thomastech/PixelRadio/include/readme.txt

Apr-14-2022
This folder is for your special include files. It is currently an empty folder.
