thomastech/PixelRadio/docs/Hardware/Schematic_RevB.pdf

# PIXEL RADIO

# FM Transmitter with RBDS/RDS

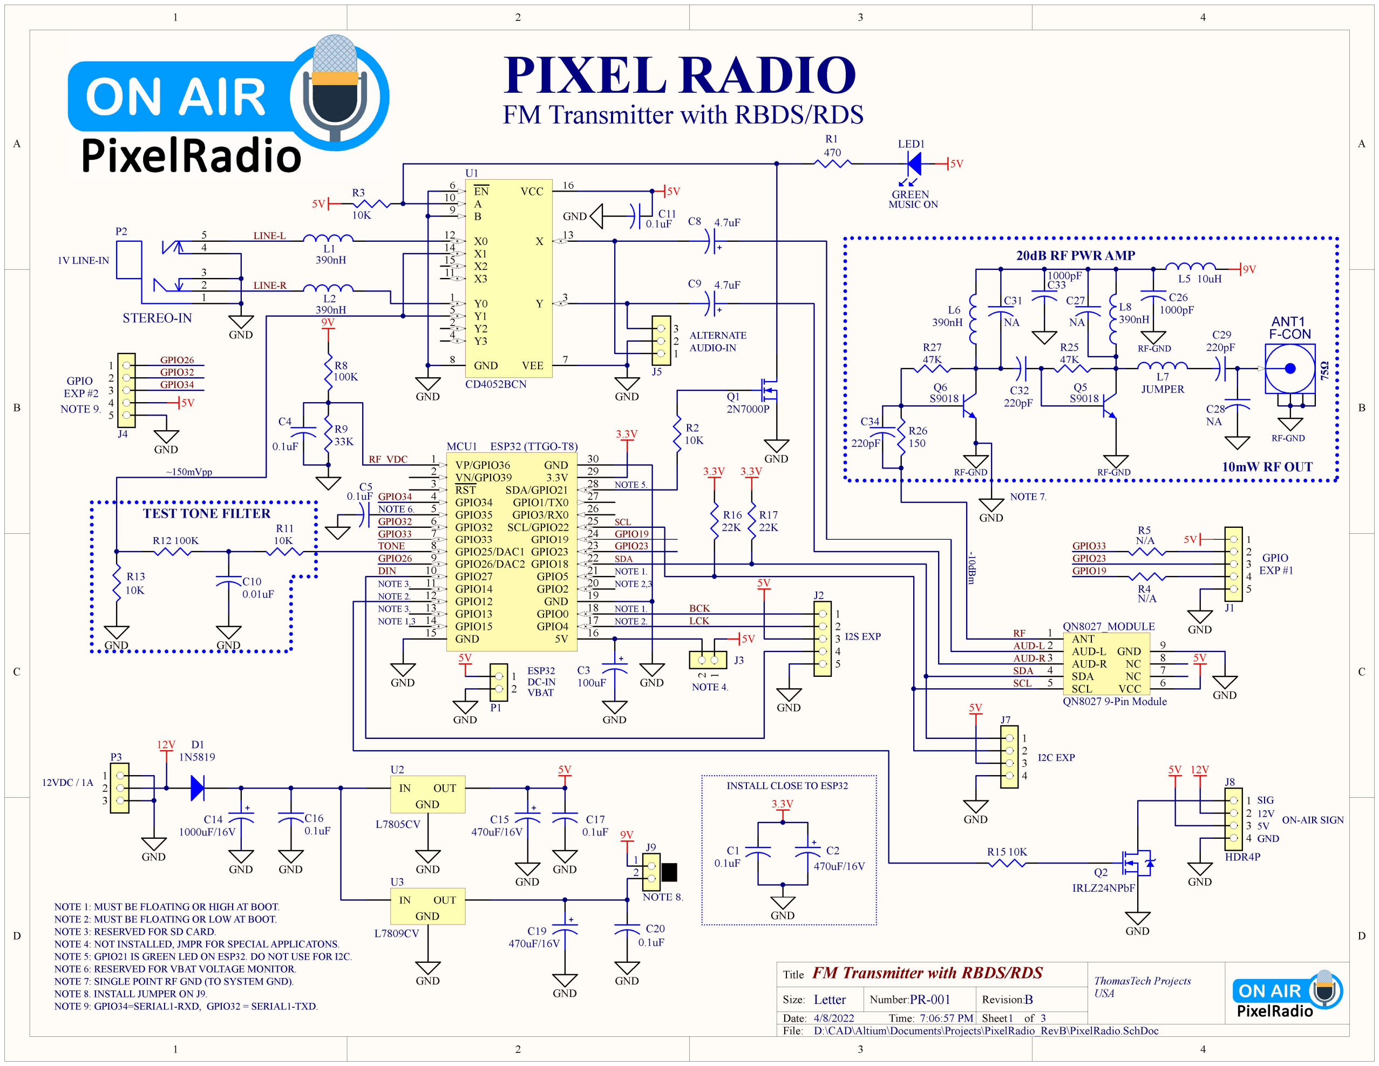
[picture p14: page 1]

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
ThomasTech Projects
USA

## FM Transmitter with RBDS/RDS

PR-001 | B
4/8/2022 | 7:06:57 PM
D:\CAD\Altium\Documents\Projects\PixelRadio_RevB\PixelRadio.SchDoc

Title

Size: | Number:
Date:
File:

Revision:
Time: | Sheet | of

### Letter

3.3V 29
RST 3

VP/GPIO36 1
VN/GPIO39 2

GPIO34 4

GPIO32 6
GPIO33 7
GPIO25/DAC1 8
GPIO26/DAC2 9
GPIO27 10
GPIO14 11
GPIO12 12
GPIO13 13

GND 30

GPIO15 14

GPIO2 | 20
GPIO0 | 18
GPIO4 | 17
GPIO5 | 21 GPIO18 | 22
GPIO19 | 24
SDA/GPIO21 | | 28
GPIO3/RX0 | 26 GPIO1/TX0 | 27
SCL/GPIO22 | | 25
GPIO23 | | 23
GND | 19

GPIO35 5

GND 15 | 5V | 16

MCU1 ESP32 (TTGO-T8)

GND

3.3V

NOTE 1,3

NOTE 1.
NOTE 2,3
NOTE 2.

NOTE 2: MUST BE FLOATING OR LOW AT BOOT.

NOTE 1: MUST BE FLOATING OR HIGH AT BOOT.

NOTE 2.

NOTE 1.

+
C3
100uF

GND

GND

GND

SDA

NOTE 3: RESERVED FOR SD CARD.

NOTE 3.

NOTE 3.

BCK
LCK

GND

3.3V

+
C2
470uF/16V

C1
0.1uF

INSTALL CLOSE TO ESP32

### ANT1 F-CON

5V

NOTE 4: NOT INSTALLED, JMPR FOR SPECIAL APPLICATONS.

### TEST TONE FILTER

R11
R12 100K | 10K

R13
10K
GND | GND

GND

1V LINE-IN

NOTE 5: GPIO21 IS GREEN LED ON ESP32. DO NOT USE FOR I2C.

NOTE 5.

SDA
C10
0.01uF

NOTE 6.

NOTE 6: RESERVED FOR VBAT VOLTAGE MONITOR.

C5
0.1uF

1
2
P1

5V

GND

ESP32
DC-IN

ANT 1
AUD-L 2
AUD-R 3
SDA 4
SCL 5 | VCC | 6
| NC | 7
NC | 8
GND | 9

QN8027_MODULE

QN8027 9-Pin Module

+

C8 4.7uF +

C9 4.7uF
C31

NA

L6
390nH

C26
1000pF

9V

Q6
S9018

R27
47K

SCL

SCL

R8
100K

R9
33K

C4

0.1uF

IN OUT GND

U2

L7805CV

IN OUT GND

U3

L7809CV

D1
1N5819

GND

GND

9V

5V

+
C15
470uF/16V

GND

+
C19
470uF/16V

GND

### 20dB RF PWR AMP

1
2
3

P3

GND

+
C14
1000uF/16V

GND

C16
0.1uF

C20
0.1uF

GND

GND

5V

NOTE 4. ²

1

J3

GND

DIN

12VDC / 1A

NOTE 7.

NOTE 7: SINGLE POINT RF GND (TO SYSTEM GND).

R26
150

R16
22K

R17
22K

3.3V 3.3V

C17
0.1uF

GND

RF
AUD-L
AUD-R

LINE-L

LINE-R

Y2 2

Y0 1 | Y

3

Y3 4

VCC 16

Y1 5

EN 6

X

13

VEE 7 GND 8

X0 12

B

9

A

10

X3 11 | X2 15 | X1 14

U1

CD4052BCN
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
ALTERNATE
AUDIO-IN

Q1
2N7000P

GND

R3

10K

5V

R2
10K
~150mVpp | -10dBm

C11
0.1uF GND

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
I2S EXP

12V

R15 10K

GND

1
2
3
4

J8

HDR4P

GND

12V

ON-AIR SIGN

Q2
IRLZ24NPbF

LED1

GREEN

R1
470
5V

MUSIC ON

L1
390nH

L2
390nH

1
2
3
4

J7

GND

5V

I2C EXP
5V

NOTE 9: GPIO34=SERIAL1-RXD, GPIO32 = SERIAL1-TXD.

SIG
12V
5V

# GND 75Ω

### STEREO-IN

L5 10uH

J9
1
2

NOTE 8.

1
2
3
4
5
J1

GND

5V GPIO19
GPIO23
GPIO33 | R5 N/A

R4
N/A

GPIO33
GPIO23
GPIO19

GPIO

C29
220pF

RF_VDC

VBAT

### 10mW RF OUT

C34

220pF

L8
390nH

Q5
S9018

R25
47K

C32
220pF

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
GPIO32

GPIO26

GPIO34

GPIO26
GPIO32
GPIO34

TONE

GPIO
EXP #2

EXP #1

RF-GND | RF-GND

RF-GND

RF-GND

NOTE 8. INSTALL JUMPER ON J9.

NOTE 9.

L7
JUMPER
C28
NA

C33

1000pF

# PROJECT REFERENCE INFORMATION

# PIXEL RADIO

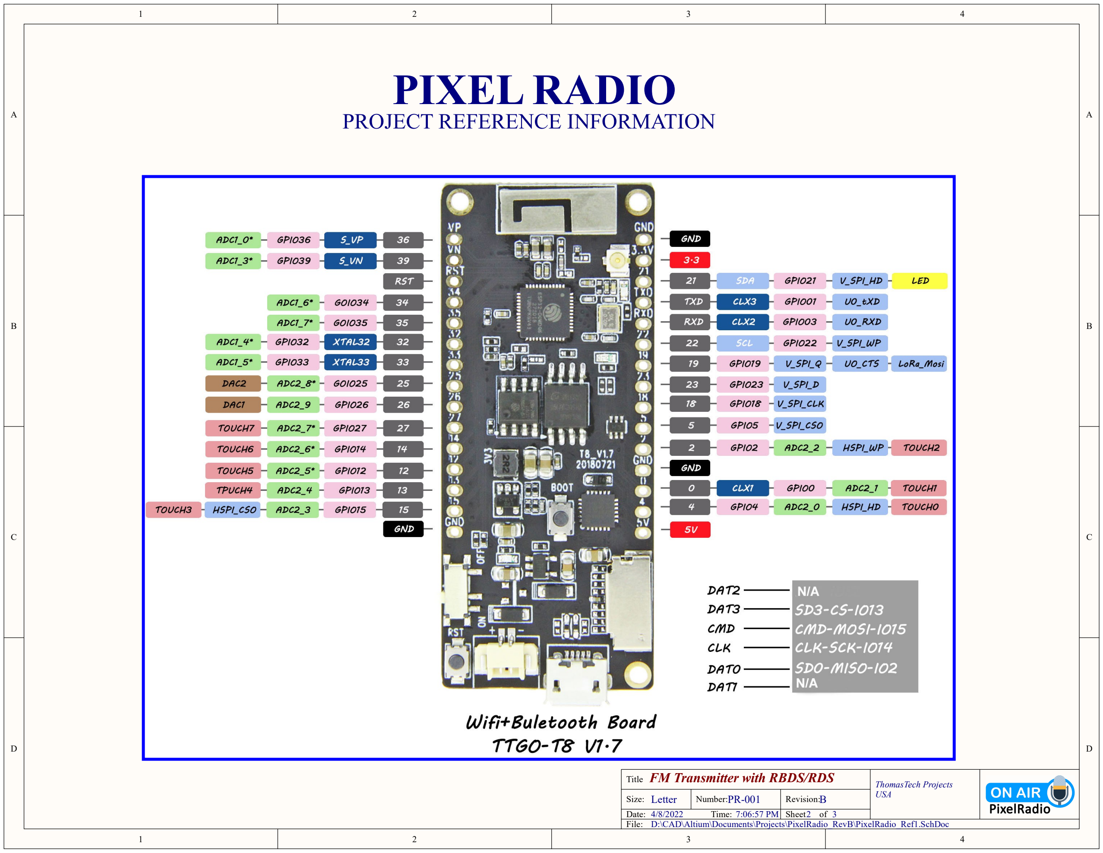
[picture p15: page 2]

D D

C C

B B

A A

## FM Transmitter with RBDS/RDS

D:\CAD\Altium\Documents\Projects\PixelRadio_RevB\PixelRadio_Ref1.SchDoc

Title

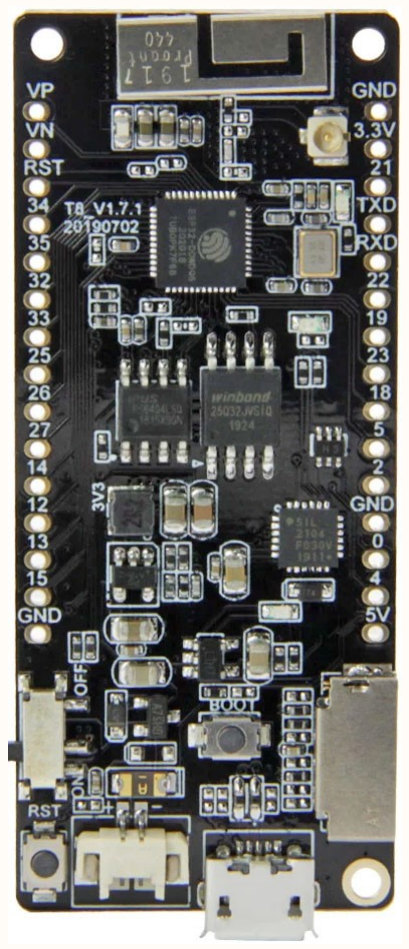
[picture p16: figure]
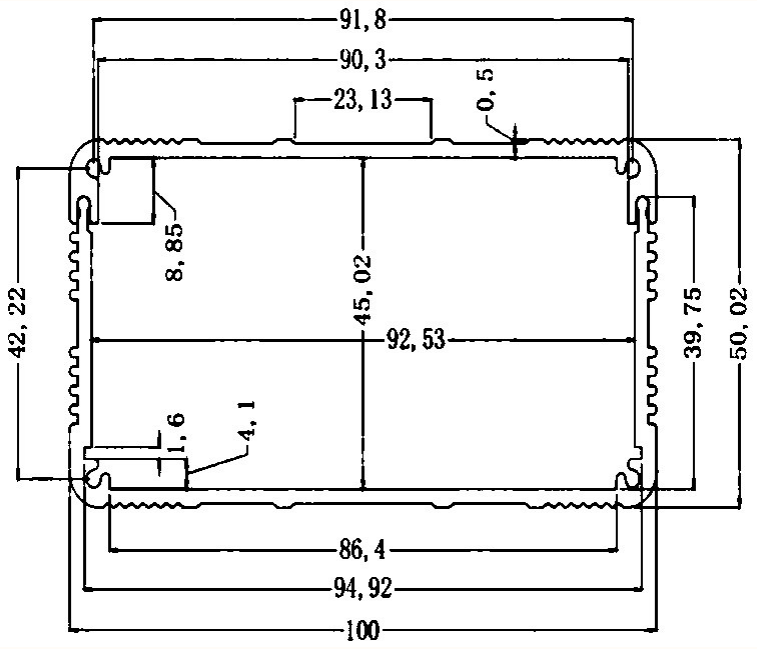
[picture p17: figure]
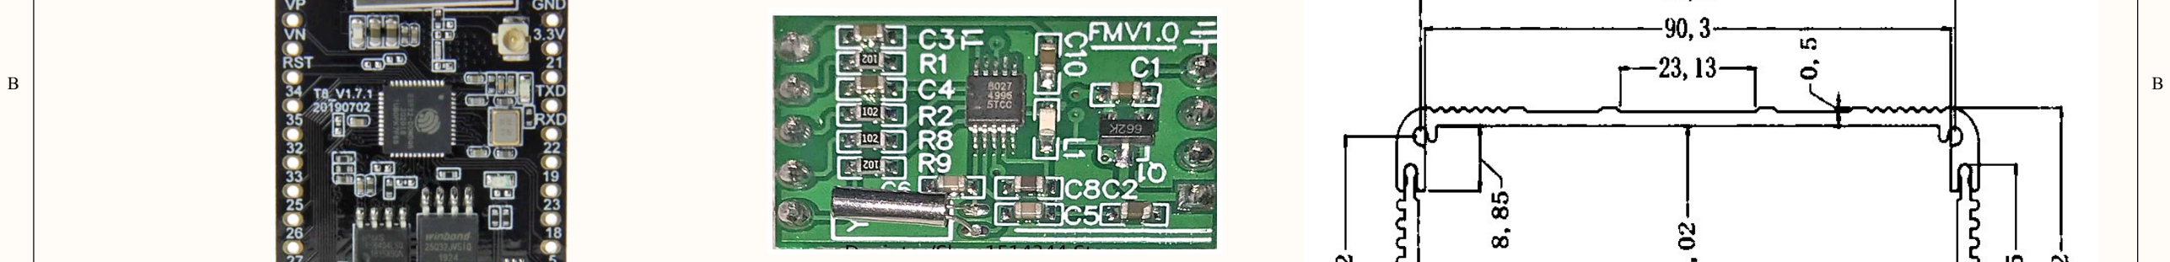
[picture p18: figure]

D D

C C

A A

## FM Transmitter with RBDS/RDS

D:\CAD\Altium\Documents\Projects\PixelRadio_RevB\PixelRadio_Ref2.SchDoc

Title

# PROJECT REFERENCE INFORMATION

# PIXEL RADIO

## ESP32 TTGO-T8 V1.7.1

## QN8027 FM TRANSMITTER

## METAL ENCLOSURE, FRONT VIEW
