thomastech/PixelRadio/docs/Images/README.md

# 

# IMAGES

PixelRadio is a DiY FM Radio Transmitter with RDS (Radio Data System) capabilities. It was developed for holiday "Pixel" displays (e.g., animated Christmas lights).

This folder contains the images used in the project's documentation.
