thomastech/PixelRadio/docs/Images/radioFail1_400.png

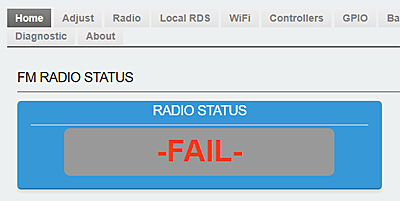
docs/Images/radioFail1_400.png
