thomastech/PixelRadio/docs/User_Manual/AboutTab.md

# 

# ABOUT TAB

PixelRadio is a FM Radio Transmitter with RDS (Radio Data System) capabilities. It was developed for holiday "Pixel" displays (e.g., animated Christmas lights).

The About Tab reports the software version and build date.

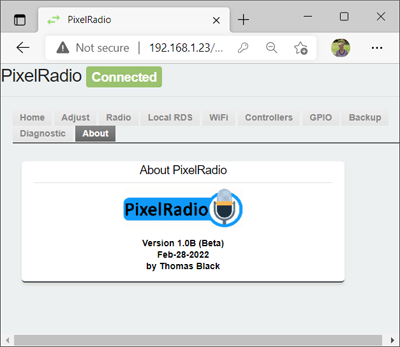
[picture p42: docs/Images/aboutTab1_400.png]


&nbsp;&nbsp;&nbsp;

## RETURN TO OVERVIEW

Return to the Menu Overview page: [Click Here](./Overview.md).
