thomastech/PixelRadio/(threads)

Thread 2 (2022-06-02):

System Run Time Freezes after 49 days

thomastech, 2022-06-02:
**Problem:** System Run Time Freezes after 49 days. Max elapsed time is 49 days, 17 hrs, 2 mins, 46 secs.
This is due to the timer's rollover limit. Classic coding mistake, shame on me.

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

This is a non-critical bug. No hurry, add to a future maintenance release.

thomastech, 2022-06-17:
Fixed. Released, see version 1.1.0.

Closed 2022-06-17.

Thread 7 (2022-12-01):

Please include pick and place file

sslupsky, 2022-12-01:
Could you please include the pick and place file for the board?  It would be possible to order an assembled board from JLCPCB if that is available.

thomastech, 2022-12-01:
Attached is the CSV File. Created today, NOT validated, use at your own risk.

[Pick Place for PixelRadio.csv](https://github.com/thomastech/PixelRadio/files/10136341/Pick.Place.for.PixelRadio.csv)

Issue complete, closed ticket.

- Thomas

sslupsky, 2022-12-01:
Thank you.

sslupsky, 2022-12-01:
Apologies, one other thing I noticed, the parts list does not have the footprint.  Could you also please provide a BOM with the footprint?

thomastech, 2022-12-01:
I'm unable to generate a useful footprint list for you without a lot of work on my end. So you'll have to create this on your own.

To get you started, attached is a basic BOM file you can use as a worksheet.

[PCB_Project_BOM.xls](https://github.com/thomastech/PixelRadio/files/10136786/PCB_Project_BOM.xls)

If JLCPCB has success with assembling your PixelRadio board then please come back and share all your files and any tips that might help the next project builder.

- Thomas

sslupsky, 2022-12-01:
Thanks for the BOM.  I can pull most of what I need out of that.  One thing that would help is the lead spacing for the radial caps.

thomastech, 2022-12-02:
The lead spacing measurements for many of the caps can be found in the big discussion at the doityourselfchristmas forum:
http://doityourselfchristmas.com/forums/showthread.php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

- Thomas

sslupsky, 2022-12-02:
Now that you mention it I seem to recall that discussion in the forum thread.  I'll go review again.  I opened the gerbers in my viewer and had a closer look at the lead spacing of those components.

sslupsky, 2022-12-03:
JLCPCB assembly looks like it will be about $50 for 5 boards.  Could save at least $2 per board I think if it was SMT.  This doesn't include the ESP32 or the RF module.

There are a few components that are difficult to source through JLCPCB/LCSC.  The thru hole inductors, the 1000pF and 220pF thru hole caps.

What is the voltage rating on C3?  I cannot find a capacitor with that footprint in a 16V rating.

Here is a screenshot of the JLC cost:
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

Let me know what you think.

sslupsky, 2022-12-03:
One thing that would be helpful is if you could add two 15 pin female headers (for the MCU) to the PCB and regenerate the placement and BOM with these two additional components.

sslupsky, 2022-12-03:
If we used SMT components I think component cost would come down as well.

thomastech, 2022-12-03:
> JLCPCB assembly looks like it will be about $50 for 5 boards.

That is a good deal.

> What is the voltage rating on C3? I cannot find a capacitor with that footprint in a 16V rating.

Minimum C3 voltage is 6.3V.

> Let me know what you think.

Some observations:

* Orientation of D1 is backwards in your screenshot.
* Double check C8 & C9 polarity. Hard to tell in the image but they look backwards to me.
* If you are using the recommended enclosure then LED1 should be hand-stuffed during final assembly so that it aligns with the hole in the front panel.

> One thing that would be helpful is if you could add two 15 pin female headers (for the MCU) to the PCB and regenerate the placement and BOM with these two additional components.

Sorry, you'll have to hand solder those.

> If we used SMT components I think component cost would come down as well.

Yes, for "production builds" an SMT layout would be important. But PixelRadio was released as a hobby project for home builders and through-hole was chosen to reduce the required soldering skills. In regards to home building, the FCC has a allowance for that activity. See Home-Built section:
https://transition.fcc.gov/Bureaus/Engineering_Technology/Documents/bulletins/oet63/oet63rev.pdf

- Thomas

sslupsky, 2022-12-03:
> Minimum C3 voltage is 6.3V.

Is there an ESR requirement for C2 ad C3?

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

Yeah, I have to figure out how to "inform" JLCPCB about forming the leads for U2 and LED1 so they are placed properly.  I am not aware of how to do that.

> > One thing that would be helpful is if you could add two 15 pin female headers (for the MCU) to the PCB and regenerate the placement and BOM with these two additional components.
>
> Sorry, you'll have to hand solder those.

I am not sure I was clear.  I am asking for the headers to be included in the BOM and placement files so the headers can be installed at JLCPCB.

> Yes, for "production builds" an SMT layout would be important. But PixelRadio was released as a hobby project for home builders and through-hole was chosen to reduce the required soldering skills. In regards to home building, the FCC has a allowance for that activity. See Home-Built section: https://transition.fcc.gov/Bureaus/Engineering_Technology/Documents/bulletins/oet63/oet63rev.pdf

I think I understand what you counsel here.  The hobbyist is required to assemble this transmitter by:

1. procurement of the carrier board, enclosure and modules,
2. insertion of the TTGO-T8 module,
3. hand soldering the RF module,
4. programming TTGO-T8 firmware,
5. assembly of enclosure,
6. jumper configuration,
7. attach antenna

The bulletin requires "their designers and builders are required to employ good engineering practices".  I think using JLCPCB assembly service helps to satisfy the "builders" part of this requirement, even more so than someone soldering one entirely from scratch.  You appear to have some significant experience in RF electronics.  So I believe this project meets the "designers" requirement as well.  So, I think the project meets the "home built" test.

thomastech, 2022-12-03:
> Is there an ESR requirement for C2 ad C3?

ESR is not critical. But I suggest using low ESR that's recommended for power supply applications.

> I am asking for the headers to be included in the BOM and placement files so the headers can be installed at JLCPCB.

See attached file (added components HDR1-MCU1 and HDR2-MCU1):
[Pick Place for PixelRadio.csv](https://github.com/thomastech/PixelRadio/files/10147168/Pick.Place.for.PixelRadio.csv)

> I think I understand what you counsel here. My interpretation is the hobbyist is required to assemble this transmitter {snip}

I don't hold a law degree so I can't offer any useful regulatory advice. But my personal method is to be as conservative as practical and do all I can to avoid stepping on gov agency toes.

- Thomas

sslupsky, 2022-12-03:
Are these inductors suitable?
https://www.bourns.com/docs/Product-Datasheets/78f_series.pdf

sslupsky, 2022-12-03:
P2 and P3 coordinates appear to be a bit off.  Can you advise regarding the origin of these components?

U2 coordinates do not match the pcb either.

I fixed polarities on D1, C8 and C9.

Substituted a 25V cap for C3 to fit the footprint.  Perhaps a high capacitance cap would be a better sub?  Not sure what the spec for this pin on TTGO T8 is.

You have a connector installed for J8 shown in the assembly tips.  What connector did you use?

sslupsky, 2022-12-03:
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

sslupsky, 2022-12-03:
I am having a hard time with the inductors (390nH, 10nH) and a few of the caps (1000pF and 220pF).  JLCPCB/LCSC has no stock on these.

thomastech, 2022-12-04:
`Are these inductors suitable?
https://www.bourns.com/docs/Product-Datasheets/78f_series.pdf`
Those are OK.

> P2 and P3 coordinates appear to be a bit off. Can you advise regarding the origin of these components?
Hmm, must be an error in the library. The best I can advise is the location of Pin 1.
P2-1 is center pin far left side, 4.659, 34.116 mm
P3-1 is center pin far left side, 5.334, 14.224 mm

sslupsky, 2022-12-05:
Updated pos of P2, P3 and U2.  Added JST XA header for J8.  Sub 470uF for C3 (used same value as the other caps to minimize number of diff parts).

Waiting for JLCPCB feedback regarding the lead forming.

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

sslupsky, 2022-12-06:
Problem with the lead forming ... JLCPCB does not support that.  I'll see if they will ship the parts with the board so we can solder them.  I do not think they will though.

Good idea on the jumper.  I was looking all over for a wire jumper and did not think of a zero ohm axial resistor.

sslupsky, 2022-12-06:
I am pretty sure the answer to this question is no but can I sub a 10uH inductor for the 390nH inductors?  I found a 10uH thru hole inductor at JLCPCB.

thomastech, 2022-12-07:
> can I sub a 10uH inductor for the 390nH inductors? I found a 10uH thru hole inductor at JLCPCB.
Please use the original value (390nH).

- Thomas

sslupsky, 2022-12-07:
I found a closer match to the 390nH inductor.  It is 150nH.  That seems more suitable but may require an adjustment to the 1000pF capacitor used in the amplifier stage.

The 10uH inductor may still be suitable for the audio input filtering.

thomastech, 2022-12-07:
>  If we use the 150nH inductor and increase the 1000pF cap to 2700pF, would that be suitable?

Regarding the 390nH sub, 150nH is not recommended (will affect performance). And keep in mind that any changes to the RF PA will require a new RF validation to ensure conformity and performance.

> The 10uH inductor may still be suitable for the audio input filtering.

L1 and L2 are for RFI/EMI protection. Changing them to 10uH should be OK, but to prevent surprises be sure to measure audio bandwidth.

- Thomas

kingofkristmas, 2022-12-25:
> I found a closer match to the 390nH inductor in stock. It is 150nH. That seems more suitable but may require an adjustment to the 1000pF capacitor used in the amplifier stage. If we use the 150nH inductor and increase the 1000pF cap to 2700pF, would that be suitable?
>
> The 10uH inductor may still be suitable for the audio input filtering.

Any luck with JLCPCB? They seem to be short on a lot of components.

thomastech, 2023-05-07:
Closed due to lack of activity.

Closed 2023-05-07.

Thread 8 (2022-12-16):

FPP and Pixel Radio Plugin Log Errors

bobreese, 2022-12-16:
I have been finding a lot of errors in my fppd logs.
[General] /opt/fpp/src/common.cpp:1007: curl_easy_perform() failed: Timeout was reached

I ended up turning on the Excessive logs in my PI 4 and found that FPP is trying to get information from the Pixel Radio on its IP:8080.

2022-12-16 10:13:13.392 (9851) [ChannelOut] /opt/fpp/src/channeloutput/UDPOutput.cpp:618: Pinging controllers to see what is online
2022-12-16 10:13:24.547 (9868) [General] /opt/fpp/src/common.cpp:1003: Calling GET http://192.168.0.102:8080/cmd?psn=n Walnut
2022-12-16 10:13:26.549 (9868) [General] /opt/fpp/src/common.cpp:1007: curl_easy_perform() failed: Timeout was reached
2022-12-16 10:13:26.549 (9868) [Plugin] src/FPPPixelRadio.cpp:157: http://192.168.0.102:8080/cmd?psn=n Walnut:   2022-12-16 10:13:26.549 (9868) [General] /opt/fpp/src/common.cpp:1003: Calling GET http://192.168.0.102:8080/cmd?rtm=%7f
2022-12-16 10:13:28.393 (9851) [ChannelOut] /opt/fpp/src/channeloutput/UDPOutput.cpp:618: Pinging controllers to see what is online
2022-12-16 10:13:28.551 (9868) [General] /opt/fpp/src/common.cpp:1007: curl_easy_perform() failed: Timeout was reached

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
[Errors.txt](https://github.com/thomastech/PixelRadio/files/10247645/Errors.txt)

thomastech, 2022-12-16:
Sorry to hear about the issue. Could be poor WiFi to the PixelRadio device (or RPI if it is running wirelessly). Check the RSSI and confirm good signal strength throughout the show.

But beyond that you'll need to report this issue to the FPP-PixelRadio plugin developer. Dan's repo is here:
https://github.com/FalconChristmas/fpp-PixelRadio

- Thomas

bobreese, 2022-12-16:
-38 to 42dBm with the show running.
I did post over in Dan's repo

thomastech, 2022-12-17:
Thanks for reporting the issue at FalconChristmas. I don't use their PixelRadio plugin so hopefully the dev can duplicate the issue and provide assistance.

- Thomas

Closed 2023-05-07.

Thread 11 (2023-01-26):

Picture of assembled board

muhuna, 2023-01-26:
Can you add some picture of the assembled board on the front page. It would help a lot for people to verify they are doing the right thing.

thomastech, 2023-01-26:
Photos and basic hardware build details are published in the documentation.
See:
https://github.com/thomastech/PixelRadio/tree/main/docs/Hardware

Closed 2023-05-07.

Thread 12 (2024-03-13):

Bad VDC

davidcharlessmith516, 2024-03-13:
I continue to receive a 'BAD-VDC' message in the Radio Status box, although the device appears to broadcast properly.

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

I have tried three different 12V power adapters, 500mA, 1A & 2A and they all show roughly the same numbers in the diagnostics.

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

Is there some physical issue with the board that I can troubleshoot? Do I have an incorrect setting somewhere (it's been like this since I first powered it on).

thomastech, 2024-03-14:
The displayed RF PA Voltage measurement is wrong. Should be 9VDC. That is the reason for the BAD-VDC message.

Confirm that jumper J9 is installed. Re-solder the connections to this.
Confirm that you have approx 9VDC across C20.
Confirm that you have approx 9VDC across C26.

If all those things are correct then there is likely a bad solder connection or incorrect component at R8, R9 & C4. And check pin 1 of the MCU1 and its socket.

- Thomas

davidcharlessmith516, 2024-03-14:
Thank you for responding so quickly. I swapped out the jumper for a different one and have the same BAD-VDC. I will search for my multimeter tomorrow to check the voltages, as the rest of the house is asleep right now. In the meantime, I will also share what may be another cause of the issue:

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

In trimming my solder joints, I scraped the board a little bit. Sure enough, this is right in between R8 and R9 where you guessed there could be an issue. In the photo, R8 is on the right and R9 is on the left. Not sure if this is causing the issue and/or if it is repairable if that's the case, but since it is right in the neighborhood of the components you said could have an issue, I thought I'd mention it.

I'll let you know what I come up with on the voltages when I find my multimeter.

Thanks again!

davidcharlessmith516, 2024-03-14:
I had roughly 8.95V across both C20 and C26.
I confirmed continuity across J9 with the jumper installed.
I still had the BAD-VDC message and the same low RF PA Voltage

I went through and resoldered C20, C26, R8, R9 and C4.
This resolved the issue. I now have no error message and 8.8 RF PA Voltage

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

Thank you for your guidance. This is a very neat and extremely useful project that you came up with and I appreciate that you continue to maintain and support it.

thomastech, 2024-03-14:
You are welcome. Thank you for reporting the solution.
- Thomas

Closed 2024-03-14.

Thread 13 (2024-12-02):

URL Decode needed?

kylegrymonprez, 2024-12-02:
The FPP Plugin was failing in curl with malformed URLs. to make it suceed, the Content of the URLs needed to be url encoded so " " would travel across to the pixelradio device as "%20". This seems to work fine for Sont text, however, the station text is displaying at "%20" instead of being URL decoded. I coudlnt' figure out the correct plave to URL decode the strings correctly, so perhaps you could quickly update the correct line of code to properly URL Decode the strings and transmit them correctly.

thomastech, 2024-12-03:
I don't use the FPP plugin that was created by Daniel Kulp. So I might not be able to solve this issue. Here's some ideas:

1. Try replacing the space (or %20) with a plus (+) sign . That is an alternate for a URL space char.
2. Perhaps an underscore ( _ ) instead of %20 will solve this for you. The underscore is fairly stealth looking.

BTW, it is not clear which RDS payload that is causing the grief. When you say "station text," is it the PSN (program station name) that is not working when you pad with %20. Or do you mean a different RDS payload?

Keep in mind that PSN is typically the station call letters, but can be a very short name. Maximum 8 chars, including any encoding characters.

kylegrymonprez, 2024-12-03:
Yeah - I think the plugin is handling cycling the PSN payload - so to get the cURL to succeed to PixelRadio, the URL has to be url encoded.

The Plugin splits it into 8 characters that cycle on a timer. e.g. my show name is "Lights at Ardmore". I set that to the Station ID in the plugin where applicable.
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

The plugin splits that into chunks of 8 characters - I see another issue in my attempted fix that worked for the RDS text, but I'll double check the code again to see if there's a separate issue. Last time I checked it was taking the URL encoded payload for PSN and displaying it verbatim on the display. So "Lights At Ardmore" got split into 3 chunks of 8 characters including the url encoded chars. However I may have spotted an issue in my own code to fix that - just need an radio to verify the other side (because the PixelRadio webpage only displays the RDS love, not the station code..... and I dont have serial logging connected....)

thomastech, 2024-12-04:
It's probably best to check the plugin's code.  It must handle any URL encoding before passing the text string to PixelRadio.

I don't have any experience with the FPP plugin. But thinking about what it should do, one issue is that only 8 chars can be sent to PixelRadio's PSN command at a time. So if %20 encoding is used, and it does not fit in a single 8 char payload, it won't be decoded as a space.
What I mean is, splitting **Lights%20At%20Ardmore** would be broken into:
Payload 1: Lights%2
Payload 2: 0At%20Ar
Payload 3: more

Sending that won't work correctly. So as a workaround, it might be best to use a single character to represent a space. Such hyphens, underscores, tildes, periods, etc.

Keep in mind that using the Station ID for messaging is not actually permitted in the RDS standards. It was intended for fixed station ID only.

kylegrymonprez, 2024-12-04:
Yeah - that's kind of representative of what I saw on the radio. I think there's 2 parts of it that are seperate but connected - the sending via curl and the displaying and they're intertwined and its escaping me to think it through the easy solution. There's a simple solution I'm sure - let me continue messing around with it.

Thanks Thomas! You've been helpful for sure.

thomastech, 2025-01-06:
Closed due to inactivity.

Closed 2025-01-06.
