thomastech/PixelRadio/(commit log)

2022-04-05 Added PCB Images
2022-04-05 Add STL Files
2022-04-05 Update STL (3D Prints)
2022-04-09 Added notes for "ON AIR" sign and External WiFi Antenna
2022-04-09 Fix URL to u.FL Cable Supplier
2022-04-09 Added Info for "Music On" LED
2022-04-12 Added ESP32 Installation Instructions
2022-04-12 Minor edit to ESP32 Installation Instructions
2022-05-10 Update Artwork Doc, edits concerning PCB thickness.
2022-06-06 Updated PCB Specifications
2023-01-15 update MUX/DEMUX IC to current part
2026-10-28 Updated ESP32 Flashing Instructions.
